lukasznowarkiewicz/smart-battery-research/img/bq40z50_status_during_charging.png

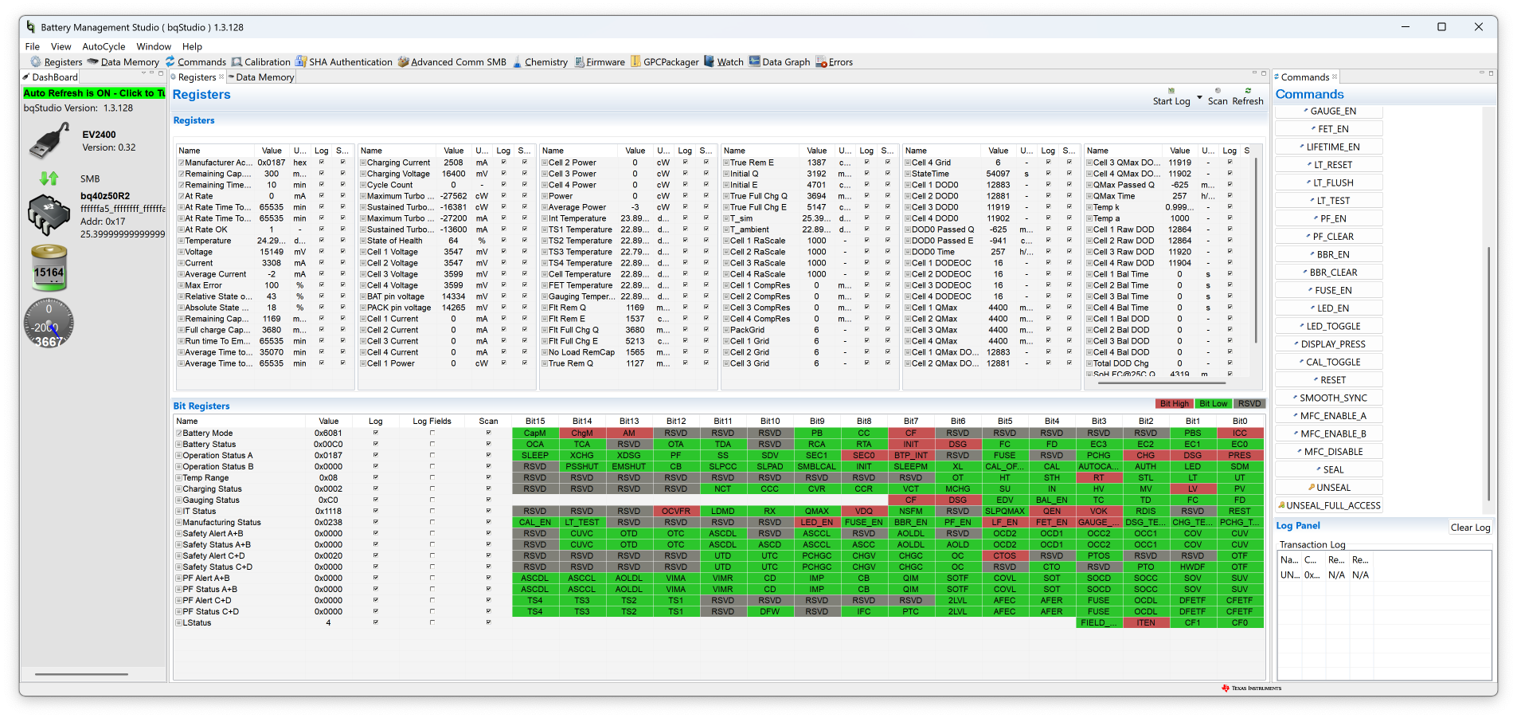
img/bq40z50_status_during_charging.png
