lukasznowarkiewicz/smart-battery-research/img/read-communication-over-smbus.png

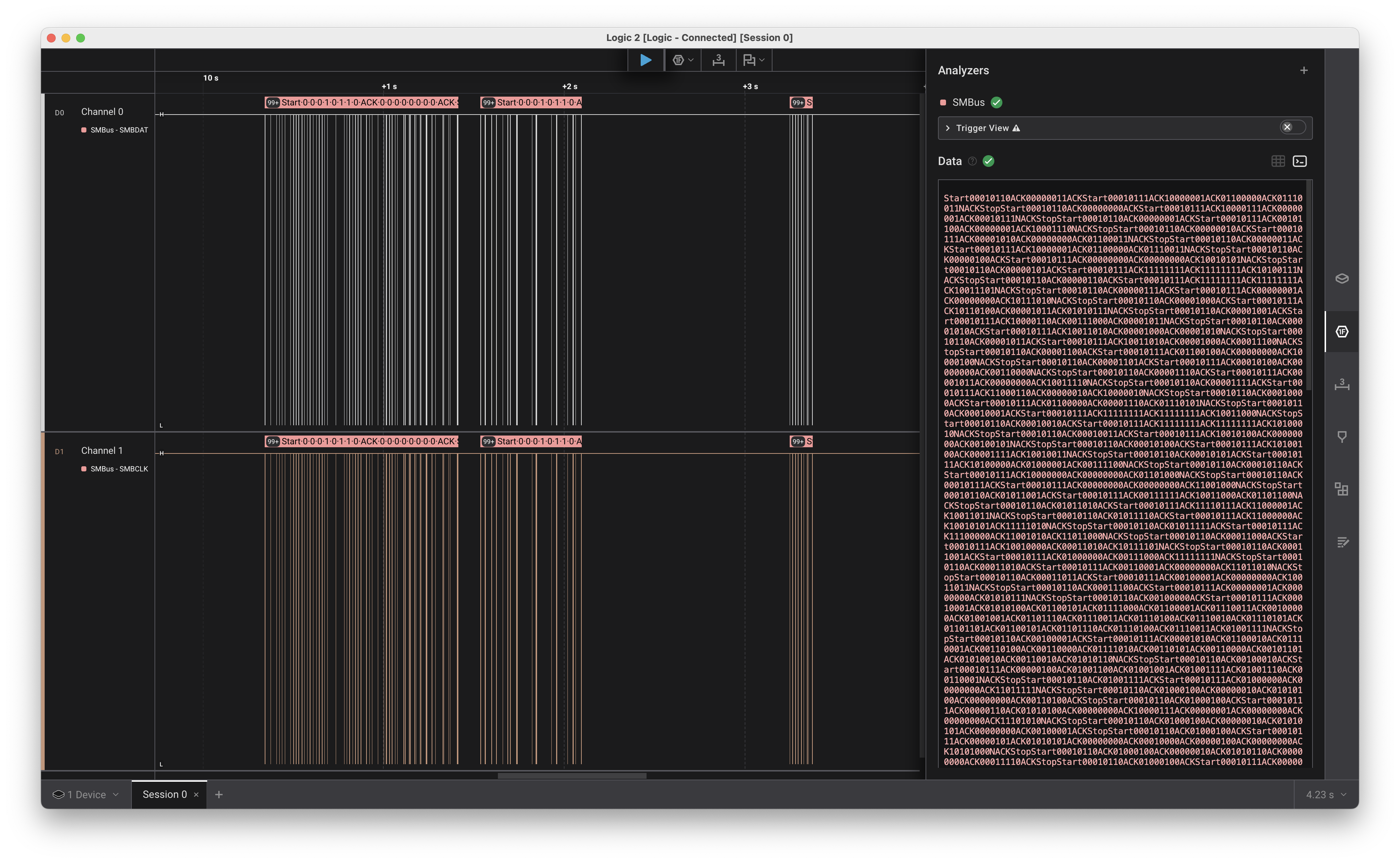
img/read-communication-over-smbus.png
