lukasznowarkiewicz/smart-battery-research/doc/4s2p 18650 holder/BOM_Board1_PCB1_2025-11-21.csv

No. | Quantity | Comment | Designator | Footprint | Value | Manufacturer Part | Manufacturer | Supplier Part | Supplier
1 | 4 | BH-18650-B1BA007 | BT9,BT10,BT11,BT12 | BAT-SMD_BH-18650-B1BA007 |  | BH-18650-B1BA007 | MYOUNG(美阳) | C6937126 | LCSC
2 | 1 | KF128-2.54-5P | U1 | CONN-TH_5P-P2.54_KF128-2.54-5P |  | KF128-2.54-5P | KEFA(科发) | C474923 | LCSC
