lukasznowarkiewicz/smart-battery-research/doc/4s2p 18650 holder/612c5448-9884-489b-971c-28aeeb22b4c5.pdf

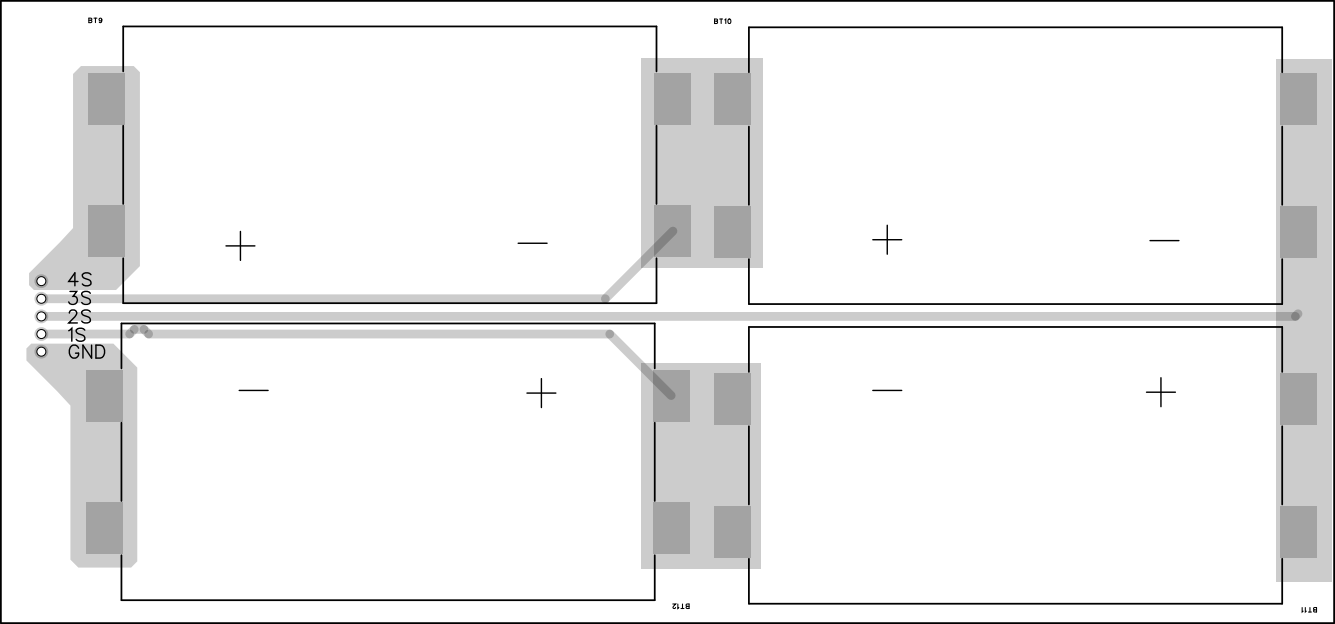
[picture p16: page 1]

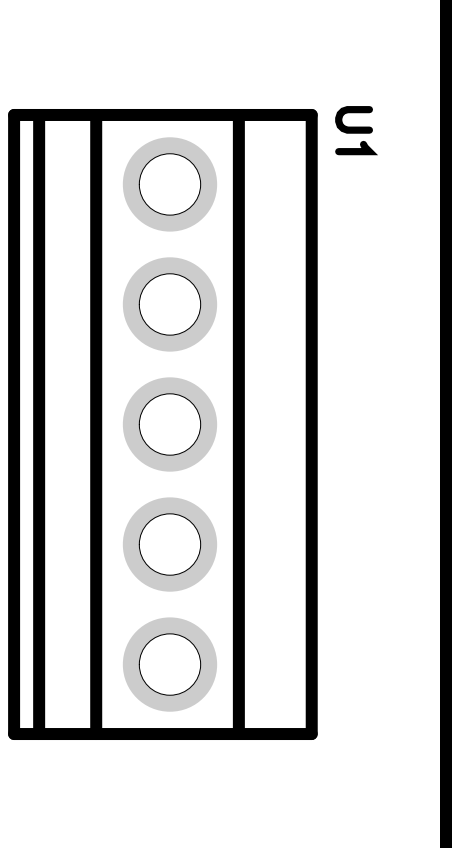
[picture p17: page 2]
