lukasznowarkiewicz/smart-battery-research/(list of files, drawings)

Other design files:
doc/4s2p 18650 holder/ProPrj_4s2p 18650 holder_2025-11-21.epro
